topherCantrell/robots-topherBot/art/art.docx

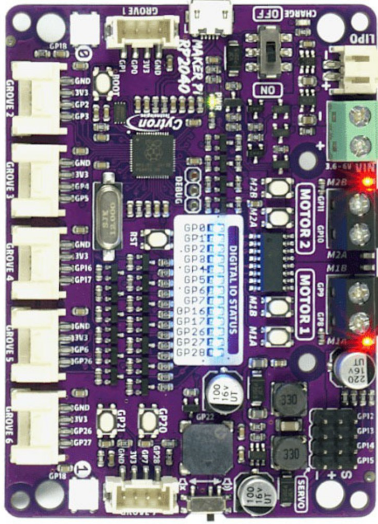
[picture p14: figure]
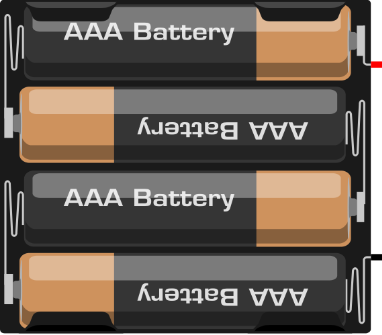
[picture p15: figure]
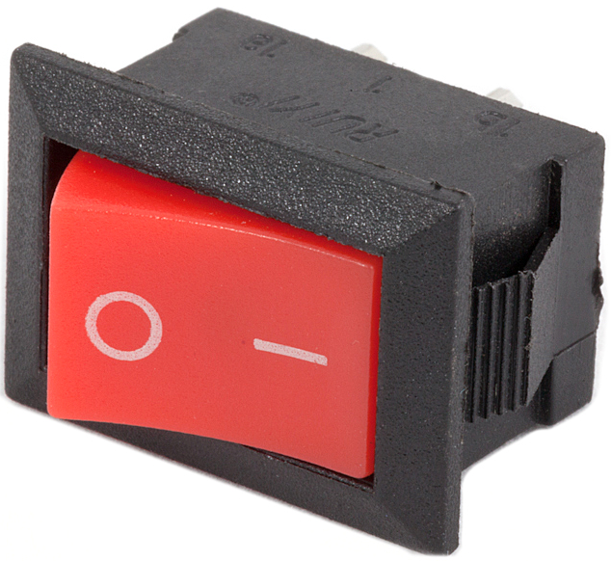
[picture p16: figure]
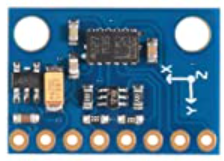
[picture p17: figure]
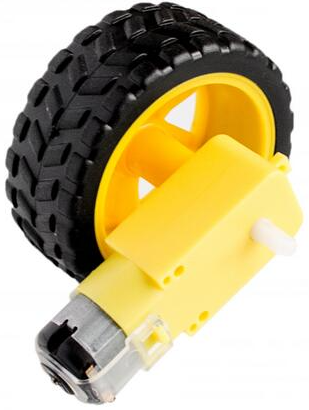
[picture p18: figure]

Compass Module

RP2040 Robot Controller

Grove Cable

Left Motor

Right Motor

Batteries (3.6V to 6V)

Power Switch
