topherCantrell/robots-topherBot/art/CompassBot1.jpg

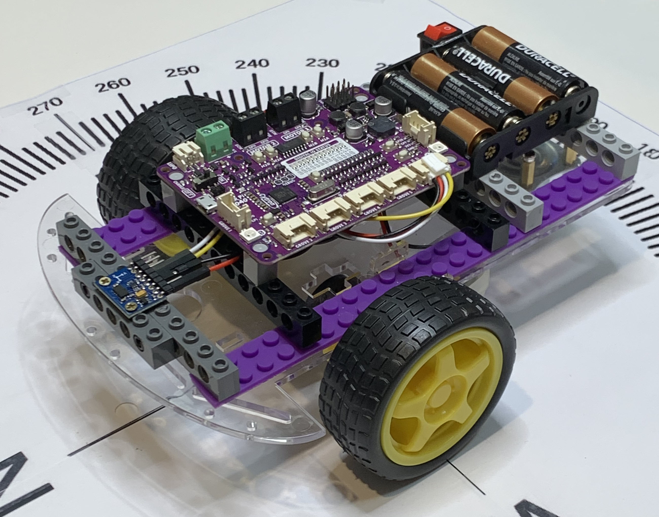
art/CompassBot1.jpg
