topherCantrell/robots-topherBot/art/CompassBot2.jpg

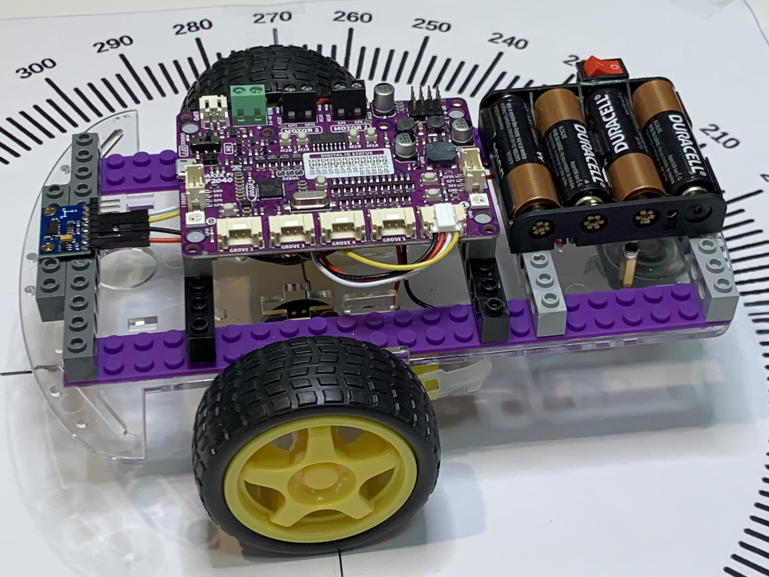
art/CompassBot2.jpg
