topherCantrell/robots-topherBot/art/CompassBot4.jpg

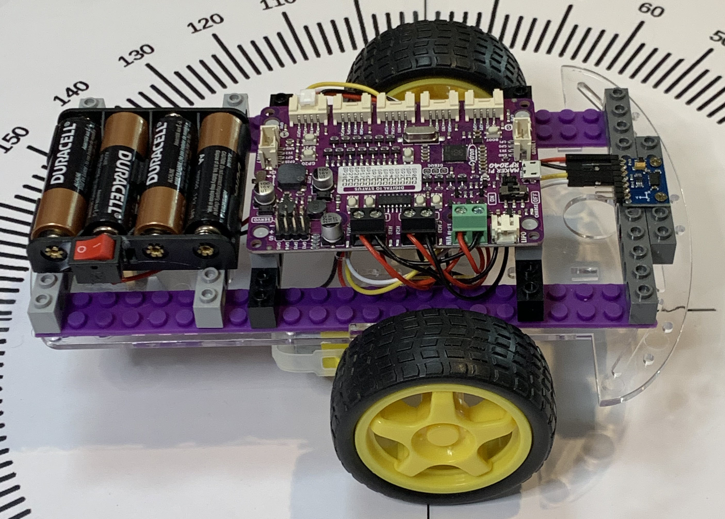
art/CompassBot4.jpg
