topherCantrell/robots-topherBot/art/esp8266.jpg

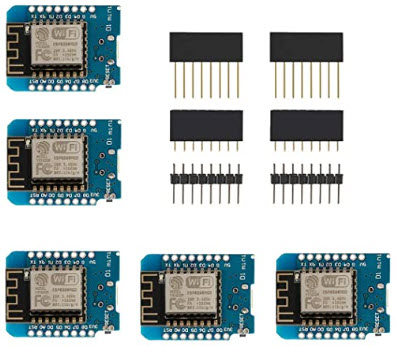
art/esp8266.jpg
