topherCantrell/robots-topherBot/art/grove.jpg

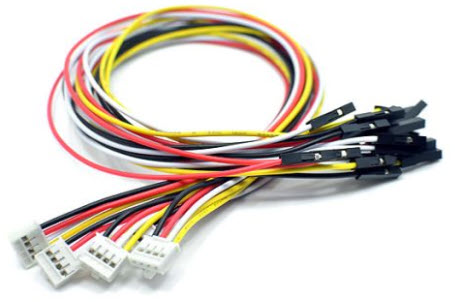
art/grove.jpg
