topherCantrell/robots-topherBot/art/hat.jpg

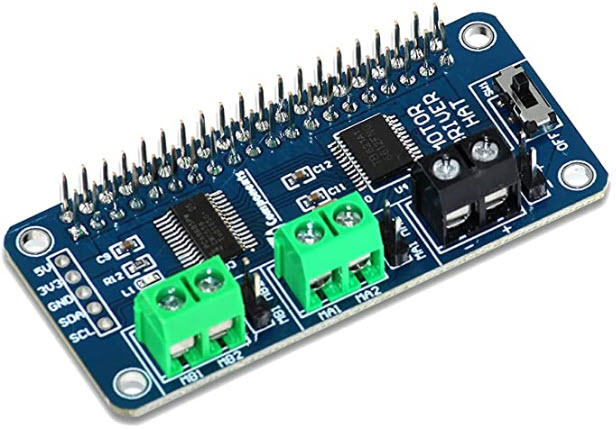
art/hat.jpg
