topherCantrell/robots-topherBot/art/protractor.png

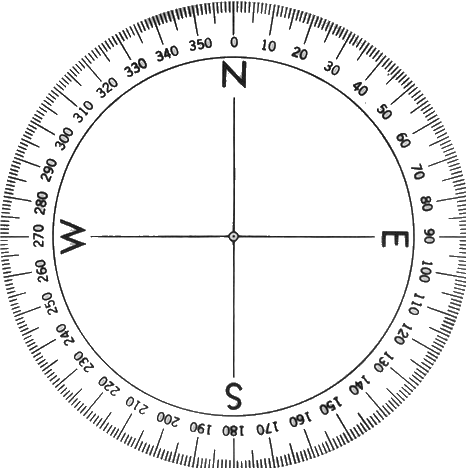
art/protractor.png
