topherCantrell/robots-topherBot/art/schematic.jpg

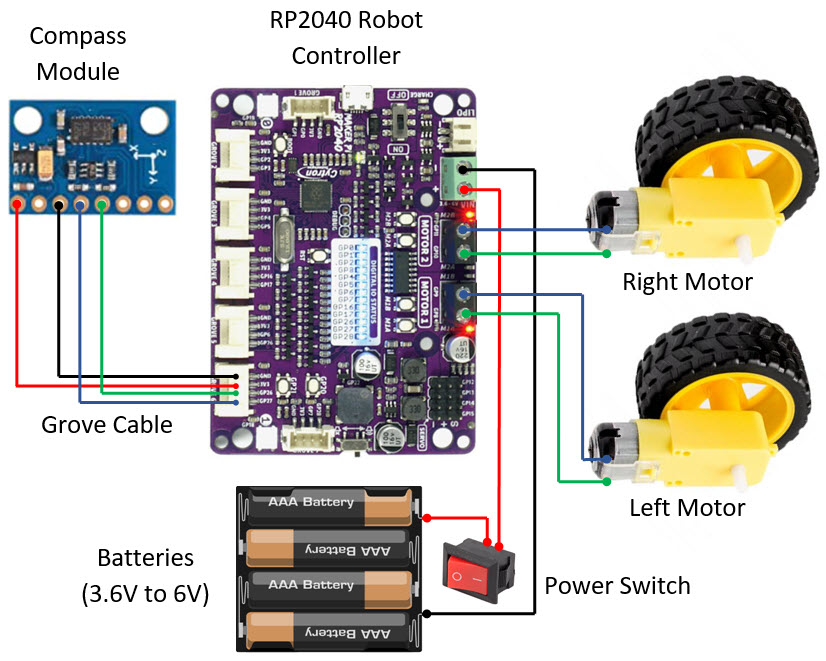
art/schematic.jpg
