topherCantrell/robots-topherBot/(commit log)

2016-12-31 Added to schematic
2017-04-08 updated the quick-start schematic ref
2018-07-07 Updated schematic
2022-10-28 Added calibration plots
